paigefo/PP_KiCAD/teensy_library-master/README.md

Donate using Liberapay (https://liberapay.com/xengi/donate)

Teensy symbol library for KiCAD
=======================================

This repo includes KiCAD symbols for the following Teensy versions:

  - Teensy 1.0
  - Teensy++ 1.0
  - Teensy 2.0
  - Teensy++ 2.0
  - Teensy 3.0
  - Teensy 3.1
  - Teensy 3.2
  - Teensy 3.5
  - Teensy 3.6
  - Teensy 4.0
  - Teensy 4.1
  - Teensy LC

There are two symbols for Teensy 3.5/3.6: one that includes the through-hole connections on Teensy and one that adds all of the SMT connections on the bottom of the Teensy.

For footprints look here: https://github.com/XenGi/teensy.pretty
