paigefo/PP_KiCAD/2QC+2FSM/3220-10-0100-00.STEP

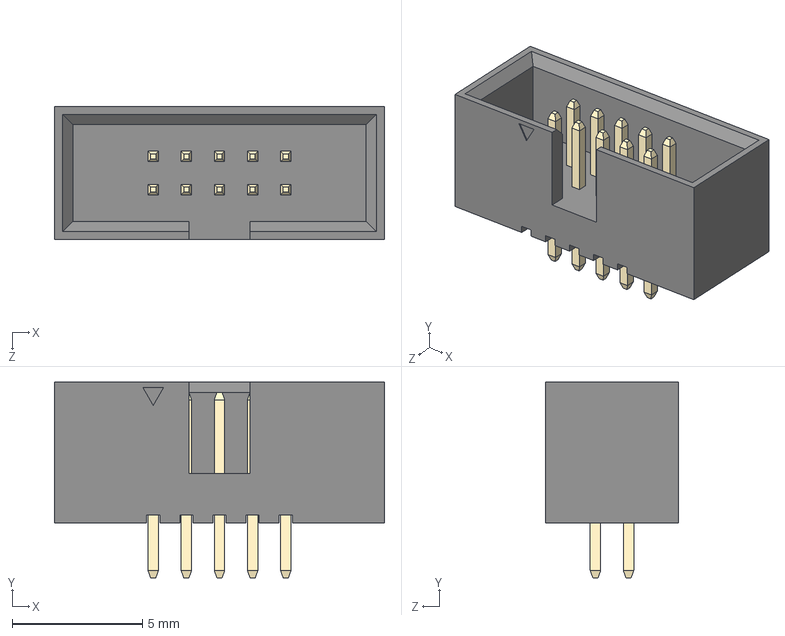
[picture p1: CAD file, 2025-09-08]
2QC+2FSM/3220-10-0100-00.STEP
12.7 x 7.50 x 5.10 mm
3220-xx-0100-00 body_10
Pin^3220-xx-0100-00 x 10
