paigefo/PP_KiCAD/Mirror+QC_Control.step

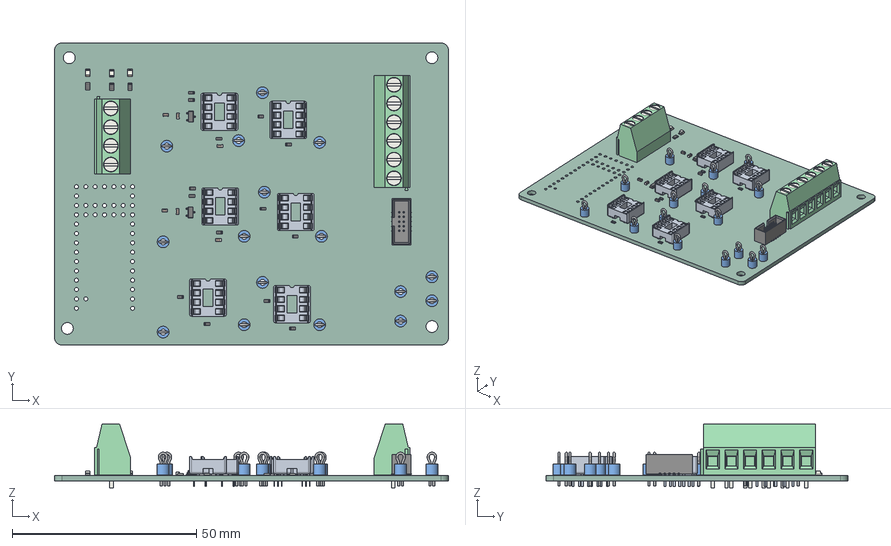
[picture p2: CAD file, 2025-09-08]
Mirror+QC_Control.step
107.0 x 82.0 x 17.3 mm
R_0603_1608Metric x 14
C_0603_1608Metric x 6
LED_0805_2012Metric x 3
TestPoint_Loop_D2.60mm_Drill1.6mm_Beaded x 16
c-1-2199298-2-a-3d x 6
SOT-23 x 2
R_0805_2012Metric x 3
TerminalBlock_Phoenix_MKDS-1,5-4-5.08_1x04_P5.08mm_Horizontal
3220-xx-0300-00 body_10
Pin^3220-xx-0300-00 x 5
MirrorPin^3220-xx-0300-00 x 5
TerminalBlock_Phoenix_MKDS-1,5-6-5.08_1x06_P5.08mm_Horizontal
Mirror+QC_Control_PCB
