paigefo/PP_KiCAD/2QC+2FSM/2QC+2FSM.kicad_pcb

## KiCad design 2QC+2FSM/2QC+2FSM.kicad_pcb (2025-10-07)

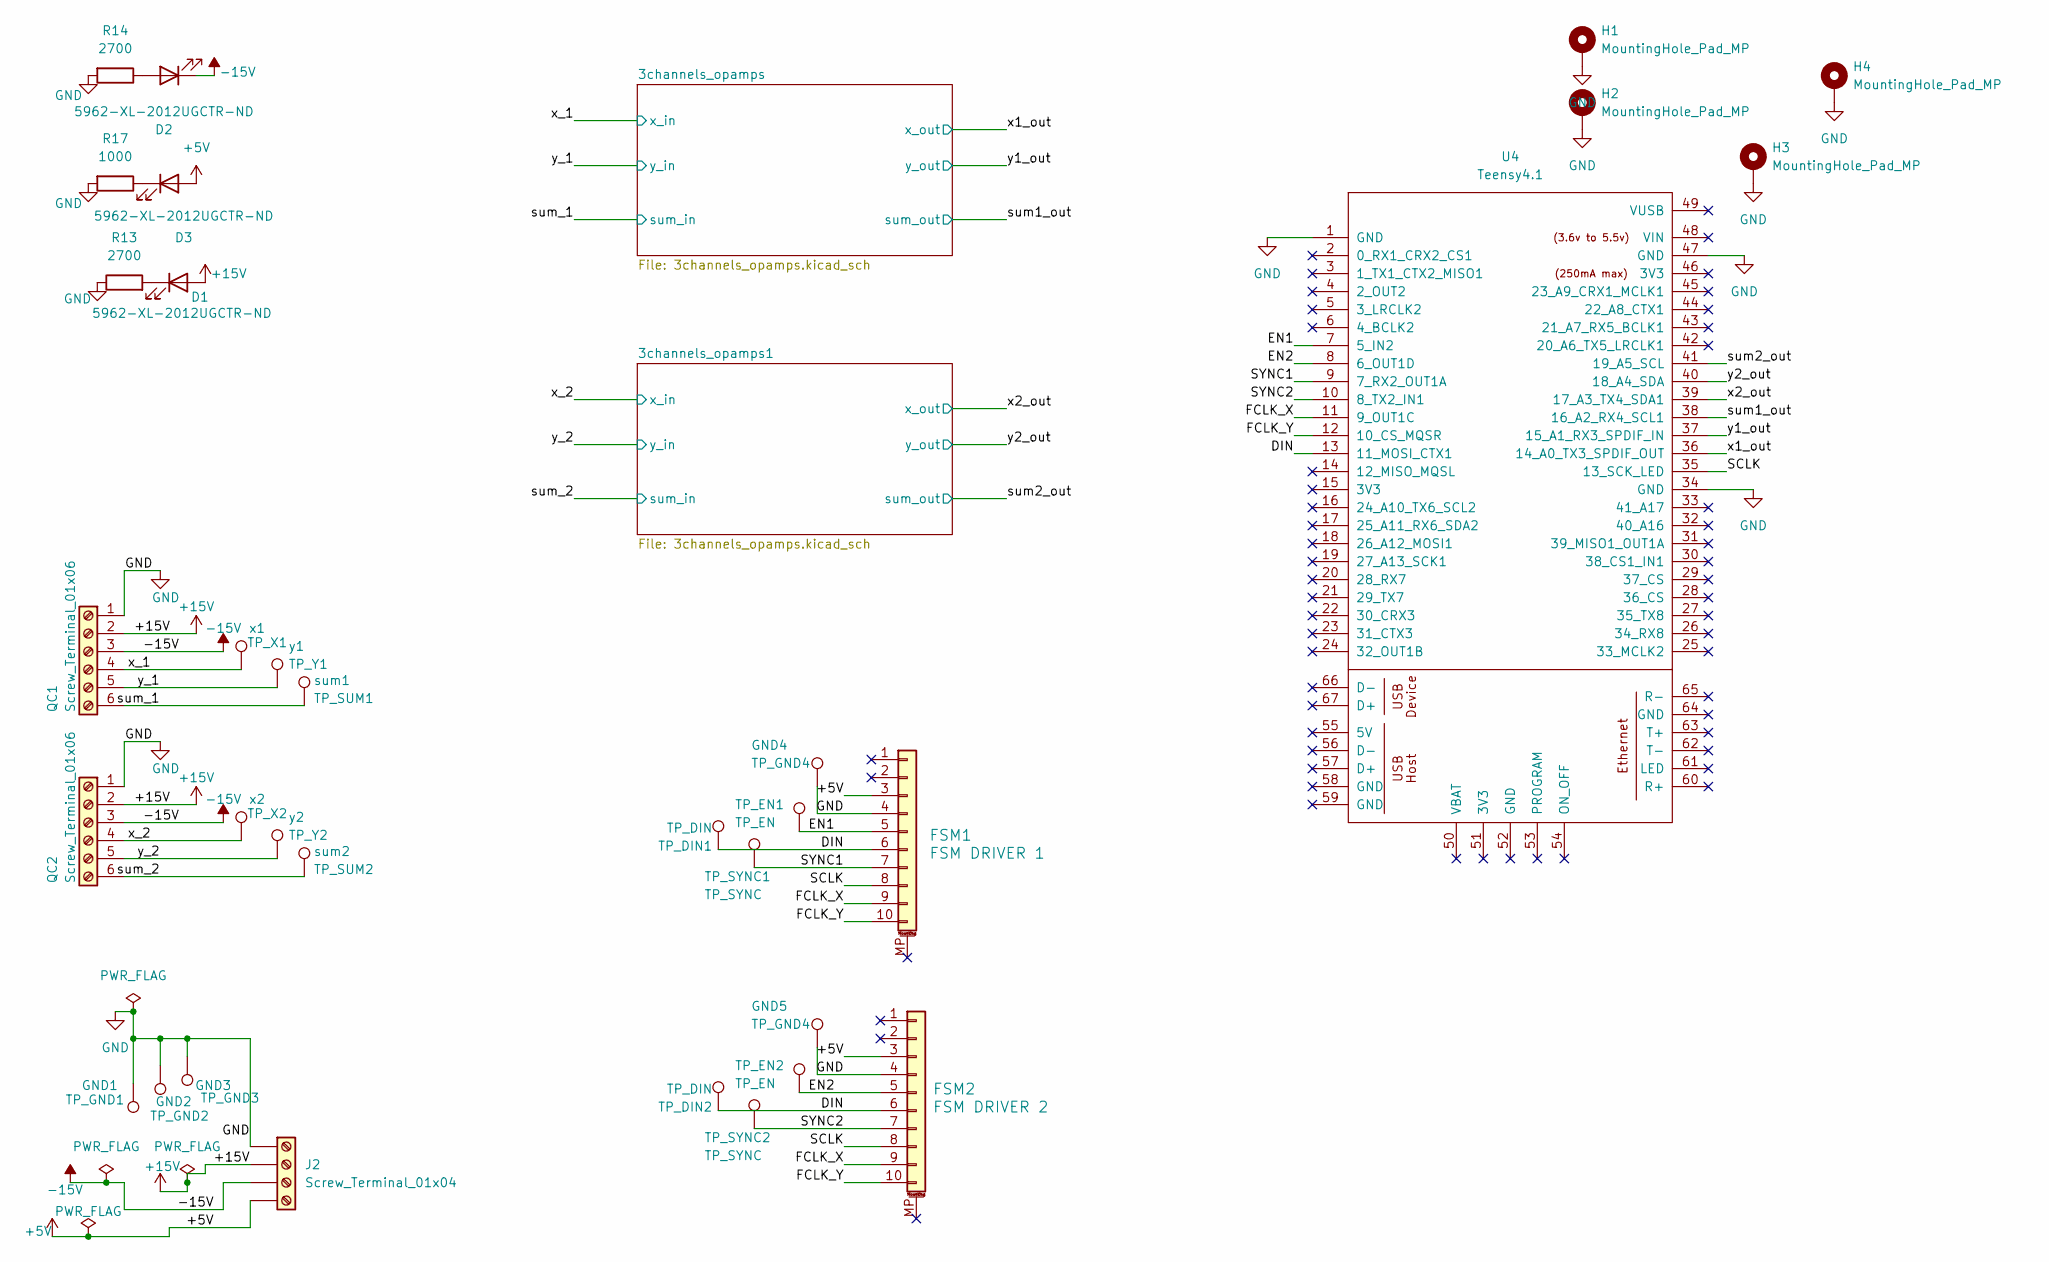
[picture p3: schematic 2QC+2FSM.kicad_sch, Teensy Control of 2QCs and 2FSMs]

Parts:
D1, D2, D3: 5962-XL-2012UGCTR-ND; LED_0805_2012Metric; LCSC C965815
FSM1: FSM DRIVER 1; CONN_3220-10-0100-00_CNC
FSM2: FSM DRIVER 2; CONN_3220-10-0100-00_CNC
GND1: TP_GND1; TestPoint_Loop_D2.60mm_Drill1.6mm_Beaded; LCSC C2906763
GND2: TP_GND2; TestPoint_Loop_D2.60mm_Drill1.6mm_Beaded; LCSC C2906763
GND3: TP_GND3; TestPoint_Loop_D2.60mm_Drill1.6mm_Beaded; LCSC C2906763
GND4, GND5: TP_GND4; TestPoint_Loop_D2.60mm_Drill1.6mm_Beaded; LCSC C2906763
H1, H2, H3, H4: MountingHole_Pad_MP; MountingHole_3.2mm_M3_DIN965_Pad_TopBottom
J2: Screw_Terminal_01x04; TerminalBlock_Phoenix_MKDS-1,5-4-5.08_1x04_P5.08mm_Horizont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; LCSC C5443561
QC1, QC2: Screw_Terminal_01x06; TerminalBlock_Phoenix_MKDS-1,5-6-5.08_1x06_P5.08mm_Horizont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; LCSC C2915642
R13, R14: 2700; R_0805_2012Metric; LCSC C2907305
R17: 1000; R_0805_2012Metric; LCSC C95781
TP_DIN1, TP_DIN2: TP_DIN; TestPoint_Loop_D2.60mm_Drill1.6mm_Beaded; LCSC C2906763
TP_EN1, TP_EN2: TP_EN; TestPoint_Loop_D2.60mm_Drill1.6mm_Beaded; LCSC C2906763
TP_SYNC1, TP_SYNC2: TP_SYNC; TestPoint_Loop_D2.60mm_Drill1.6mm_Beaded; LCSC C2906763
U4: Teensy4.1; Teensy41
sum1: TP_SUM1; TestPoint_Loop_D2.60mm_Drill1.6mm_Beaded; LCSC C2906763
sum2: TP_SUM2; TestPoint_Loop_D2.60mm_Drill1.6mm_Beaded; LCSC C2906763
x1: TP_X1; TestPoint_Loop_D2.60mm_Drill1.6mm_Beaded; LCSC C2906763
x2: TP_X2; TestPoint_Loop_D2.60mm_Drill1.6mm_Beaded; LCSC C2906763
y1: TP_Y1; TestPoint_Loop_D2.60mm_Drill1.6mm_Beaded; LCSC C2906763
y2: TP_Y2; TestPoint_Loop_D2.60mm_Drill1.6mm_Beaded; LCSC C2906763

Connections:
+5V: D3.2 (A), FSM1.3, FSM2.3, J2.4; also elsewhere on the board
+15V: D1.2 (A), J2.2, QC1.2, QC2.2; also elsewhere on the board
-15V: D2.1 (K), J2.3, QC1.3, QC2.3; also elsewhere on the board
/DIN: FSM1.6, FSM2.6, TP_DIN1.1, TP_DIN2.1, U4.13 (11_MOSI_CTX1)
/EN1: FSM1.5, TP_EN1.1, U4.7 (5_IN2)
/EN2: FSM2.5, TP_EN2.1, U4.8 (6_OUT1D)
/FCLK_X: FSM1.9, FSM2.9, U4.11 (9_OUT1C)
/FCLK_Y: FSM1.10, FSM2.10, U4.12 (10_CS_MQSR)
/SCLK: FSM1.8, FSM2.8, U4.35 (13_SCK_LED)
/SYNC1: FSM1.7, TP_SYNC1.1, U4.9 (7_RX2_OUT1A)
/SYNC2: FSM2.7, TP_SYNC2.1, U4.10 (8_TX2_IN1)
/sum1_out: U4.38 (16_A2_RX4_SCL1); also elsewhere on the board
/sum2_out: U4.41 (19_A5_SCL); also elsewhere on the board
/sum_1: QC1.6, sum1.1; also elsewhere on the board
/sum_2: QC2.6, sum2.1; also elsewhere on the board
/x1_out: U4.36 (14_A0_TX3_SPDIF_OUT); also elsewhere on the board
/x2_out: U4.39 (17_A3_TX4_SDA1); also elsewhere on the board
/x_1: QC1.4, x1.1; also elsewhere on the board
/x_2: QC2.4, x2.1; also elsewhere on the board
/y1_out: U4.37 (15_A1_RX3_SPDIF_IN); also elsewhere on the board
/y2_out: U4.40 (18_A4_SDA); also elsewhere on the board
/y_1: QC1.5, y1.1; also elsewhere on the board
/y_2: QC2.5, y2.1; also elsewhere on the board
GND: FSM1.4, FSM2.4, GND1.1, GND2.1, GND3.1, GND4.1, GND5.1, H1.MP, H2.MP, H3.MP, H4.MP, J2.1, QC1.1, QC2.1, R13.1, R14.2, R17.2, U4.1 (GND), U4.34 (GND), U4.47 (GND); also elsewhere on the board
unnamed: D1.1 (K), R13.2
unnamed: D2.2 (A), R14.1
unnamed: D3.1 (K), R17.1

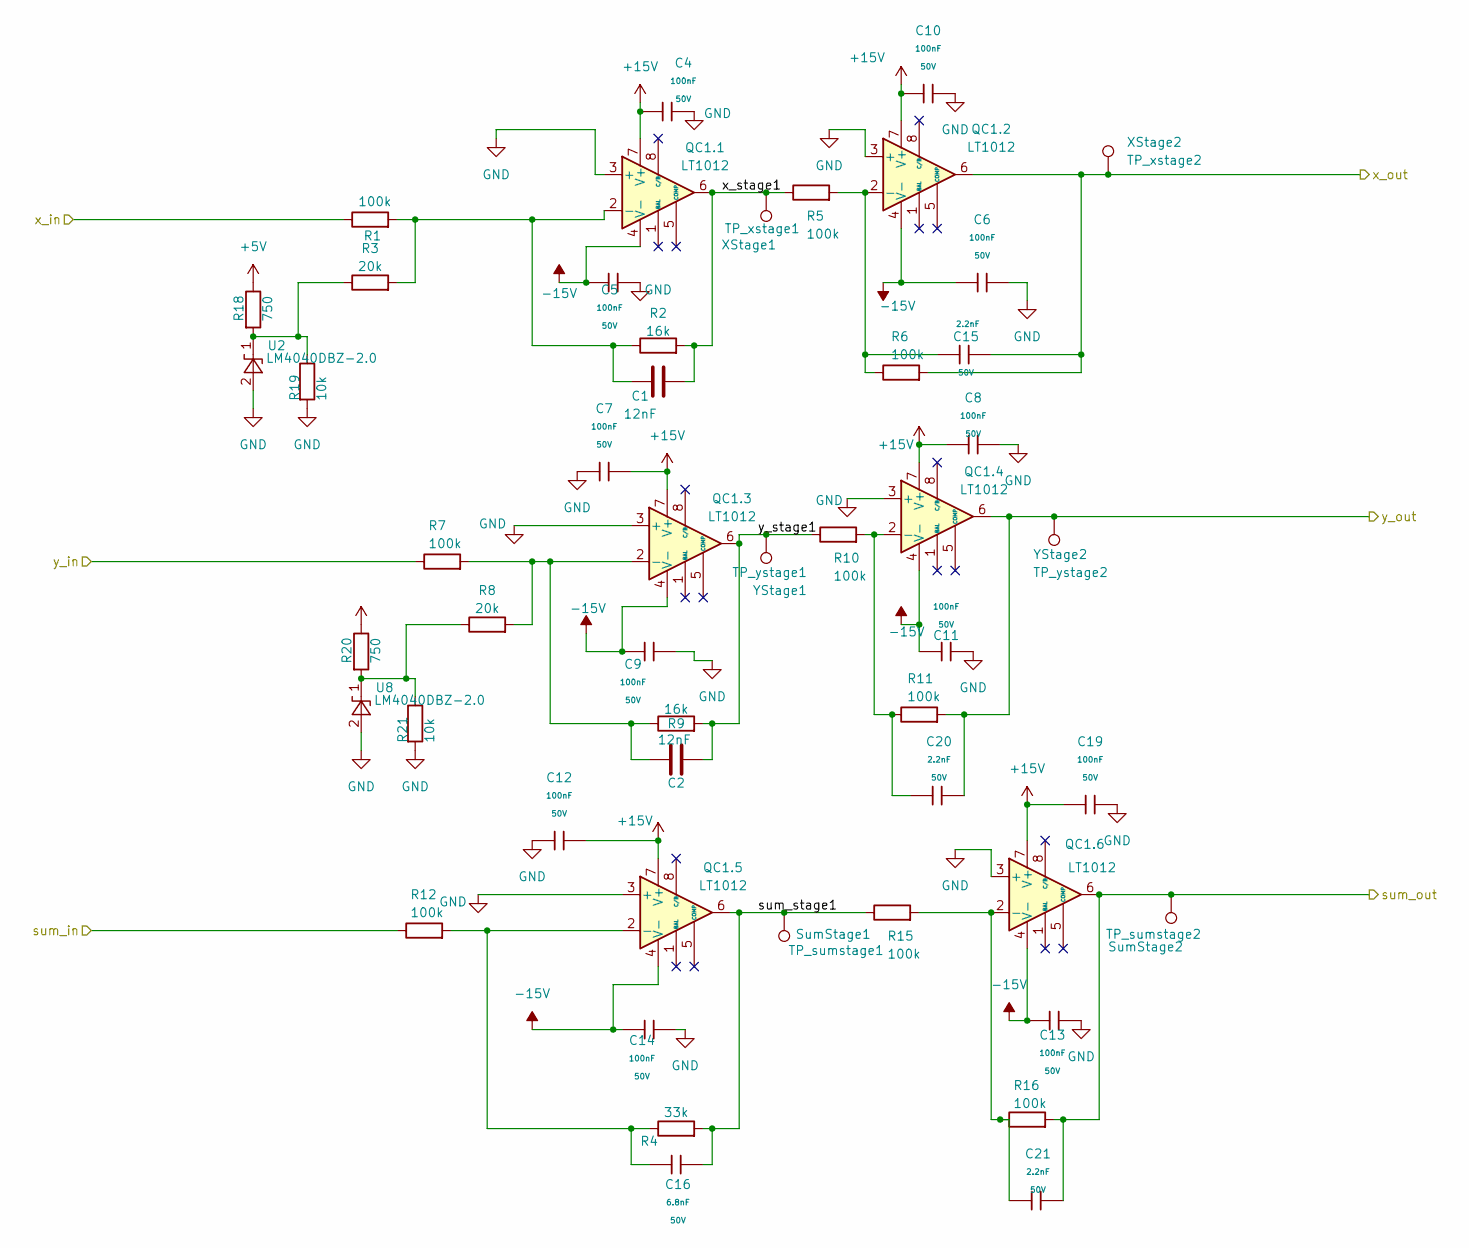
[picture p4: schematic 3channels_opamps.kicad_sch, X,Y,Sum conversion to 0-3.3V]

Parts:
C1, C2: 12nF; C_0603_1608Metric; LCSC C107074
C4, C5, C6, C7, C8, C9, C10, C11, C12, C13, C14, C19: 100nF; C_0603; Voltage Rated 50V; Tolerance ±10%; Part CC0603KRX7R9BB104; LCSC C14663
C15, C20, C21: 2.2nF; C_0603; Voltage Rated 50V; Tolerance ±10%; Part 0603B222K500NT; LCSC C1604
C16: 6.8nF; C_0603; Voltage Rated 50V; Tolerance ±10%; Part 0603B682K500NT; LCSC C1631
QC1.1, QC1.2, QC1.3, QC1.4, QC1.5, QC1.6: LT1012; CONN8_1-2199298-2_TEC; LCSC C305904
R1, R5, R6, R7, R10, R11, R12, R15, R16: 100k; R_0603_1608Metric; LCSC C14675
R2, R9: 16k; R_0603_1608Metric; LCSC C2907107
R3, R8: 20k; R_0603_1608Metric; LCSC C2907011
R4: 33k; R_0603_1608Metric; LCSC C2907028
R18, R20: 750; C_0603_1608Metric; LCSC C2907066
R19, R21: 10k; C_0603_1608Metric; LCSC C2930027
SumStage1: TP_sumstage1; TestPoint_Loop_D2.60mm_Drill1.6mm_Beaded; LCSC C2906763
SumStage2: TP_sumstage2; TestPoint_Loop_D2.60mm_Drill1.6mm_Beaded; LCSC C2906763
U2, U8: LM4040DBZ-2.0; SOT-23; LCSC C431732
XStage1: TP_xstage1; TestPoint_Loop_D2.60mm_Drill1.6mm_Beaded; LCSC C2906763
XStage2: TP_xstage2; TestPoint_Loop_D2.60mm_Drill1.6mm_Beaded; LCSC C2906763
YStage1: TP_ystage1; TestPoint_Loop_D2.60mm_Drill1.6mm_Beaded; LCSC C2906763
YStage2: TP_ystage2; TestPoint_Loop_D2.60mm_Drill1.6mm_Beaded; LCSC C2906763

Connections:
+5V: R18.1, R20.1; also elsewhere on the board
+15V: C4.1, C7.2, C8.1, C10.1, C12.2, C19.1, QC1.1.7 (V+), QC1.2.7 (V+), QC1.3.7 (V+), QC1.4.7 (V+), QC1.5.7 (V+), QC1.6.7 (V+); also elsewhere on the board
-15V: C5.1, C6.1, C9.1, C11.1, C13.1, C14.1, QC1.1.4 (V-), QC1.2.4 (V-), QC1.3.4 (V-), QC1.4.4 (V-), QC1.5.4 (V-), QC1.6.4 (V-); also elsewhere on the board
/3channels_opamps/sum_stage1: C16.2, QC1.5.6, R4.2, R15.1, SumStage1.1
/3channels_opamps/x_stage1: C1.2, QC1.1.6, R2.2, R5.1, XStage1.1
/3channels_opamps/y_stage1: C2.1, QC1.3.6, R9.2, R10.1, YStage1.1
/sum1_out: C21.2, QC1.6.6, R16.2, SumStage2.1; also elsewhere on the board
/sum_1: R12.1; also elsewhere on the board
/x1_out: C15.2, QC1.2.6, R6.2, XStage2.1; also elsewhere on the board
/x_1: R1.1; also elsewhere on the board
/y1_out: C20.2, QC1.4.6, R11.2, YStage2.1; also elsewhere on the board
/y_1: R7.1; also elsewhere on the board
GND: C4.2, C5.2, C6.2, C7.1, C8.2, C9.2, C10.2, C11.2, C12.1, C13.2, C14.2, C19.2, QC1.1.3 (+), QC1.2.3 (+), QC1.3.3 (+), QC1.4.3 (+), QC1.5.3 (+), QC1.6.3 (+), R19.2, R21.2, U2.2 (A), U8.2 (A); also elsewhere on the board
unnamed: C1.1, QC1.1.2 (-), R1.2, R2.1, R3.2
unnamed: C15.1, QC1.2.2 (-), R5.2, R6.1
unnamed: C2.2, QC1.3.2 (-), R7.2, R8.2, R9.1
unnamed: C20.1, QC1.4.2 (-), R10.2, R11.1
unnamed: C16.1, QC1.5.2 (-), R4.1, R12.2
unnamed: C21.1, QC1.6.2 (-), R15.2, R16.1
unnamed: R3.1, R18.2, R19.1, U2.1 (K)
unnamed: R8.1, R20.2, R21.1, U8.1 (K)

Parts of its further copies:
C3, C17, C18, C22, C23, C25, C28, C30, C32, C33, C35, C36: 100nF; C_0603; Voltage Rated 50V; Tolerance ±10%; Part CC0603KRX7R9BB104; LCSC C14663
C24, C26: 12nF; C_0603_1608Metric; LCSC C107074
C27: 6.8nF; C_0603; Voltage Rated 50V; Tolerance ±10%; Part 0603B682K500NT; LCSC C1631
C29, C31, C34: 2.2nF; C_0603; Voltage Rated 50V; Tolerance ±10%; Part 0603B222K500NT; LCSC C1604
QC2.1, QC2.2, QC2.3, QC2.4, QC2.5, QC2.6: LT1012; CONN8_1-2199298-2_TEC; LCSC C305904
R22, R24: 750; C_0603_1608Metric; LCSC C2907066
R23, R27: 10k; C_0603_1608Metric; LCSC C2930027
R25, R28, R29, R34, R35, R36, R37, R38, R39: 100k; R_0603_1608Metric; LCSC C14675
R26, R30: 20k; R_0603_1608Metric; LCSC C2907011
R31, R32: 16k; R_0603_1608Metric; LCSC C2907107
R33: 33k; R_0603_1608Metric; LCSC C2907028
SumStage3: TP_sumstage1; TestPoint_Loop_D2.60mm_Drill1.6mm_Beaded; LCSC C2906763
SumStage4: TP_sumstage2; TestPoint_Loop_D2.60mm_Drill1.6mm_Beaded; LCSC C2906763
U7, U9: LM4040DBZ-2.0; SOT-23; LCSC C431732
XStage3: TP_xstage1; TestPoint_Loop_D2.60mm_Drill1.6mm_Beaded; LCSC C2906763
XStage4: TP_xstage2; TestPoint_Loop_D2.60mm_Drill1.6mm_Beaded; LCSC C2906763
YStage3: TP_ystage1; TestPoint_Loop_D2.60mm_Drill1.6mm_Beaded; LCSC C2906763
YStage4: TP_ystage2; TestPoint_Loop_D2.60mm_Drill1.6mm_Beaded; LCSC C2906763

Connections of its further copies:
+5V: R22.1, R24.1; also elsewhere on the board
+15V: C3.2, C17.2, C25.1, C28.1, C32.1, C36.1, QC2.1.7 (V+), QC2.2.7 (V+), QC2.3.7 (V+), QC2.4.7 (V+), QC2.5.7 (V+), QC2.6.7 (V+); also elsewhere on the board
-15V: C18.1, C22.1, C23.1, C30.1, C33.1, C35.1, QC2.1.4 (V-), QC2.2.4 (V-), QC2.3.4 (V-), QC2.4.4 (V-), QC2.5.4 (V-), QC2.6.4 (V-); also elsewhere on the board
/3channels_opamps1/sum_stage1: C27.2, QC2.5.6, R33.2, R36.1, SumStage3.1
/3channels_opamps1/x_stage1: C24.2, QC2.1.6, R31.2, R34.1, XStage3.1
/3channels_opamps1/y_stage1: C26.1, QC2.3.6, R32.2, R35.1, YStage3.1
/sum2_out: C34.2, QC2.6.6, R39.2, SumStage4.1; also elsewhere on the board
/sum_2: R28.1; also elsewhere on the board
/x2_out: C31.2, QC2.2.6, R37.2, XStage4.1; also elsewhere on the board
/x_2: R25.1; also elsewhere on the board
/y2_out: C29.2, QC2.4.6, R38.2, YStage4.1; also elsewhere on the board
/y_2: R29.1; also elsewhere on the board
GND: C3.1, C17.1, C18.2, C22.2, C23.2, C25.2, C28.2, C30.2, C32.2, C33.2, C35.2, C36.2, QC2.1.3 (+), QC2.2.3 (+), QC2.3.3 (+), QC2.4.3 (+), QC2.5.3 (+), QC2.6.3 (+), R23.2, R27.2, U7.2 (A), U9.2 (A); also elsewhere on the board
unnamed: C24.1, QC2.1.2 (-), R25.2, R26.2, R31.1
unnamed: C31.1, QC2.2.2 (-), R34.2, R37.1
unnamed: C26.2, QC2.3.2 (-), R29.2, R30.2, R32.1
unnamed: C29.1, QC2.4.2 (-), R35.2, R38.1
unnamed: C27.1, QC2.5.2 (-), R28.2, R33.1
unnamed: C34.1, QC2.6.2 (-), R36.2, R39.1
unnamed: R22.2, R23.1, R26.1, U7.1 (K)
unnamed: R24.2, R27.1, R30.1, U9.1 (K)

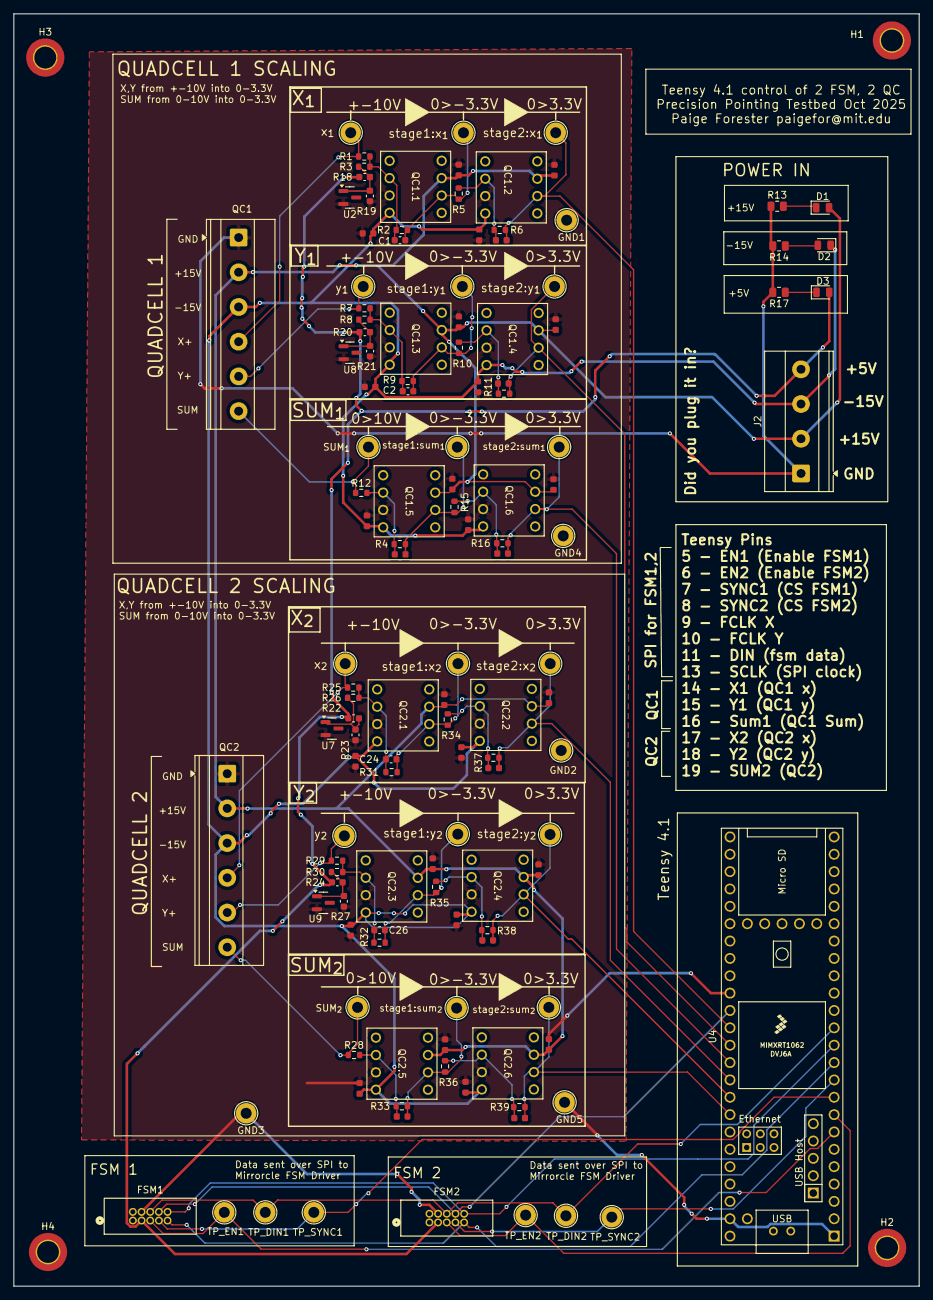
[picture p5: board 2QC+2FSM.kicad_pcb from above]

Board: 2 copper layers, 132.5 x 186.2 mm, 133 parts (0 on the bottom side), 49 nets.

Other parts of the board:
x_{1}: TP_X1; TestPoint_Loop_D2.60mm_Drill1.6mm_Beaded

Their connections:
/x_1: x_{1}.1; also elsewhere on the board
