paigefo/PP_KiCAD/Mirror+QC_Control.kicad_pcb

## KiCad design Mirror+QC_Control.kicad_pcb (2025-09-08)

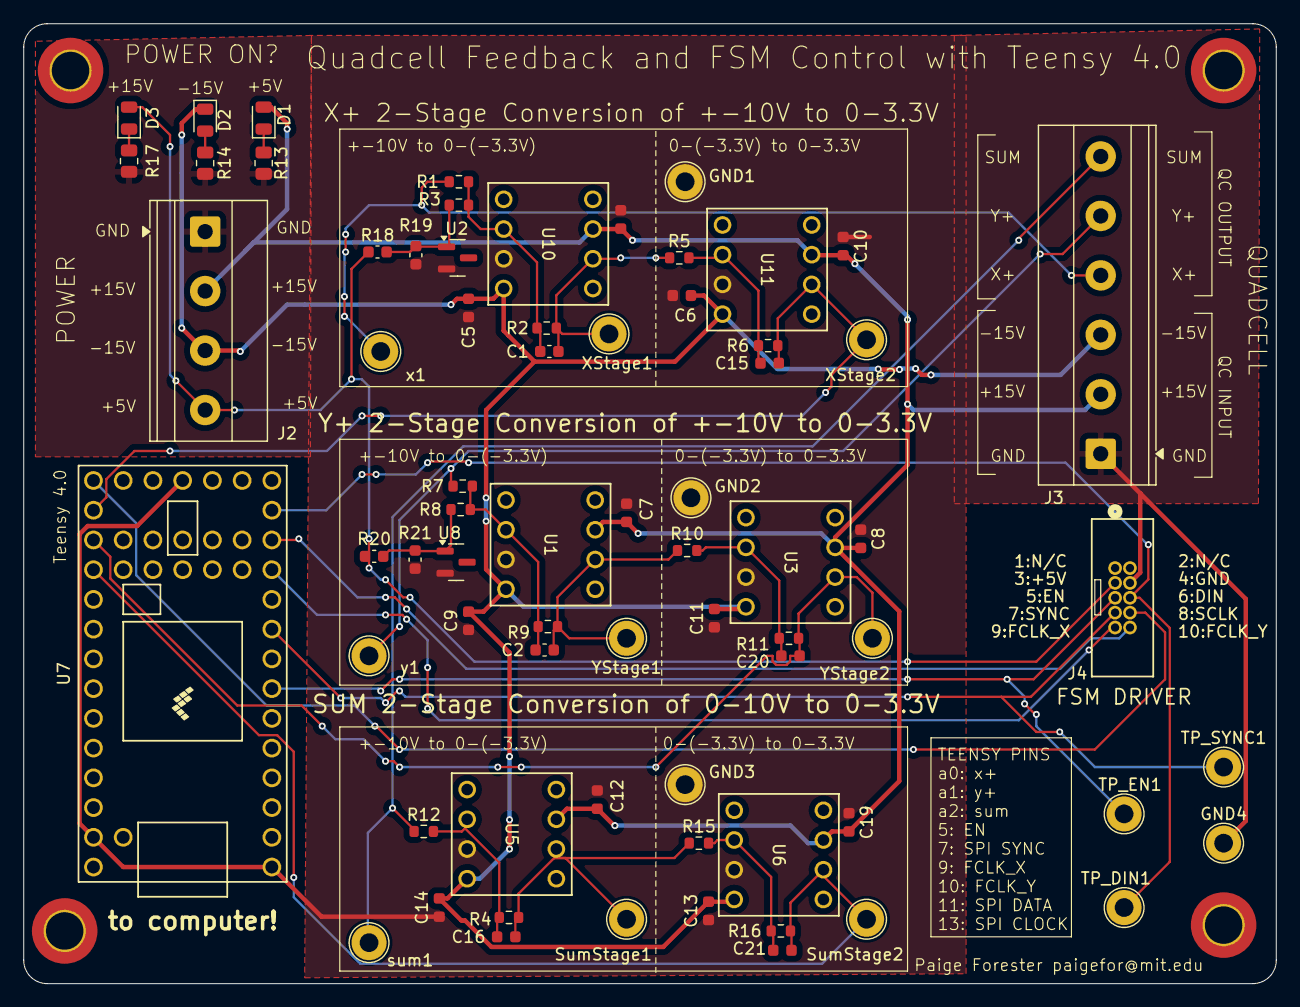
[picture p6: board Mirror+QC_Control.kicad_pcb from above]

Board: 2 copper layers, 107.0 x 82.0 mm, 74 parts (0 on the bottom side), 30 nets.

Parts:
C1, C2: 12nF; C_0603_1608Metric
C4, C5, C6, C7, C8, C9, C10, C11, C12, C13, C14, C19: 100nF; C_0603
C15, C20, C21: 2.2nF; C_0603
C16: 6.8nF; C_0603
D1, D2, D3: 5962-XL-2012UGCTR-ND; LED_0805_2012Metric
GND1: TP_GND1; TestPoint_Loop_D2.60mm_Drill1.6mm_Beaded
GND2: TP_GND2; TestPoint_Loop_D2.60mm_Drill1.6mm_Beaded
GND3: TP_GND3; TestPoint_Loop_D2.60mm_Drill1.6mm_Beaded
GND4: TP_GND4; TestPoint_Loop_D2.60mm_Drill1.6mm_Beaded
H1, H2, H3, H4: MountingHole_Pad_MP; MountingHole_3.2mm_M3_DIN965_Pad_TopBottom
J2: Screw_Terminal_01x04; TerminalBlock_Phoenix_MKDS-1,5-4-5.08_1x04_P5.08mm_Horizont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
J3: Screw_Terminal_01x06; TerminalBlock_Phoenix_MKDS-1,5-6-5.08_1x06_P5.08mm_Horizont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
J4: FSM DRIVER; CONN_3220-10-0100-00_CNC
R1, R5, R6, R7, R10, R11, R12, R15, R16: 100k; R_0603_1608Metric
R2, R9: 16k; R_0603_1608Metric
R3, R8: 20k; R_0603_1608Metric
R4: 33k; R_0603_1608Metric
R13, R14: 1200; R_0805_2012Metric
R17: 300; R_0805_2012Metric
R18, R20: 750; C_0603_1608Metric
R19, R21: 10k; C_0603_1608Metric
SumStage1: TP_sumstage1; TestPoint_Loop_D2.60mm_Drill1.6mm_Beaded
SumStage2: TP_sumstage2; TestPoint_Loop_D2.60mm_Drill1.6mm_Beaded
TP_DIN1: TP_DIN; TestPoint_Loop_D2.60mm_Drill1.6mm_Beaded
TP_EN1: TP_EN; TestPoint_Loop_D2.60mm_Drill1.6mm_Beaded
TP_SYNC1: TP_SYNC; TestPoint_Loop_D2.60mm_Drill1.6mm_Beaded
U1, U3, U5, U6, U10, U11: LT1012; CONN8_1-2199298-2_TEC
U2, U8: LM4040DBZ-2.0; SOT-23
U7: Teensy4.0; Teensy40
XStage1: TP_xstage1; TestPoint_Loop_D2.60mm_Drill1.6mm_Beaded
XStage2: TP_xstage2; TestPoint_Loop_D2.60mm_Drill1.6mm_Beaded
YStage1: TP_ystage1; TestPoint_Loop_D2.60mm_Drill1.6mm_Beaded
YStage2: TP_ystage2; TestPoint_Loop_D2.60mm_Drill1.6mm_Beaded
sum1: TP_SUM; TestPoint_Loop_D2.60mm_Drill1.6mm_Beaded
x1: TP_X; TestPoint_Loop_D2.60mm_Drill1.6mm_Beaded
y1: TP_Y; TestPoint_Loop_D2.60mm_Drill1.6mm_Beaded

Connections:
+5V: D3.2 (A), J2.4, J4.3, R18.1, R20.1
+15V: C4.1, C7.2, C8.1, C10.1, C12.2, C19.1, D1.2 (A), J2.2, J3.2, U1.7 (V+), U3.7 (V+), U5.7 (V+), U6.7 (V+), U10.7 (V+), U11.7 (V+)
-15V: C5.1, C6.1, C9.1, C11.1, C13.1, C14.1, D2.1 (K), J2.3, J3.3, U1.4 (V-), U3.4 (V-), U5.4 (V-), U6.4 (V-), U10.4 (V-), U11.4 (V-)
/DIN: J4.6, TP_DIN1.1, U7.13 (11_MOSI_CTX1)
/EN: J4.5, TP_EN1.1, U7.7 (5_IN2)
/FCLK_X: J4.9, U7.11 (9_OUT1C)
/FCLK_Y: J4.10, U7.12 (10_CS_MQSR)
/SCLK: J4.8, U7.20 (13_SCK_CRX1_LED)
/SYNC: J4.7, TP_SYNC1.1, U7.9 (7_RX2_OUT1A)
/sum: J3.6, R12.1, sum1.1
/sum_stage1: C16.2, R4.2, R15.1, SumStage1.1, U5.6
/sum_stage2: C21.2, R16.2, SumStage2.1, U6.6, U7.23 (16_A2_RX4_SCL1)
/x+: J3.4, R1.1, x1.1
/x_stage1: C1.2, R2.2, R5.1, U10.6, XStage1.1
/x_stage2: C15.2, R6.2, U7.21 (14_A0_TX3_SPDIF_OUT), U11.6, XStage2.1
/y+: J3.5, R7.1, y1.1
/y_stage1: C2.1, R9.2, R10.1, U1.6, YStage1.1
/y_stage2: C20.2, R11.2, U3.6, U7.22 (15_A1_RX3_SPDIF_IN), YStage2.1
GND: C4.2, C5.2, C6.2, C7.1, C8.2, C9.2, C10.2, C11.2, C12.1, C13.2, C14.2, C19.2, GND1.1, GND2.1, GND3.1, GND4.1, J2.1, J3.1, J4.4, R13.1, R14.2, R17.2, R19.2, R21.2, U1.3 (+), U2.2 (A), U3.3 (+), U5.3 (+), U6.3 (+), U7.1 (GND), U7.17 (GND), U7.32 (GND), U8.2 (A), U10.3 (+), U11.3 (+)
unnamed: D1.1 (K), R13.2
unnamed: D2.2 (A), R14.1
unnamed: D3.1 (K), R17.1
unnamed: C2.2, R7.2, R8.2, R9.1, U1.2 (-)
unnamed: R3.1, R18.2, R19.1, U2.1 (K)
unnamed: C20.1, R10.2, R11.1, U3.2 (-)
unnamed: C16.1, R4.1, R12.2, U5.2 (-)
unnamed: C21.1, R15.2, R16.1, U6.2 (-)
unnamed: R8.1, R20.2, R21.1, U8.1 (K)
unnamed: C1.1, R1.2, R2.1, R3.2, U10.2 (-)
unnamed: C15.1, R5.2, R6.1, U11.2 (-)
