paigefo/PP_KiCAD/(commit log)

2025-07-16 changes after DR1
    [Mirror+QC_Control.kicad_pcb, Mirror+QC_Control.kicad_sch]
2025-07-16 changes since DR2
    [Mirror+QC_Control.kicad_pcb, Mirror+QC_Control.kicad_sch]
2025-07-16 added LCSC values and refined silkscreen. still missing capacitor values for LPFs
    [Mirror+QC_Control.kicad_pcb, Mirror+QC_Control.kicad_sch]
2025-07-17 changes include capacitance values for LPFs
    [Mirror+QC_Control.kicad_pcb, Mirror+QC_Control.kicad_sch]
2025-07-17 final changes to board with nice layout
    [Mirror+QC_Control.kicad_pcb, Mirror+QC_Control.kicad_sch, bom.csv, designators.csv, positions.csv]
2025-07-17 adding all LCSC part numbers
    [Mirror+QC_Control-B_Cu.gbr, Mirror+QC_Control-B_Mask.gbr, Mirror+QC_Control-B_Paste.gbr, Mirror+QC_Control-B_Silkscreen.gbr, Mirror+QC_Control-Edge_Cuts.gbr, Mirror+QC_Control-F_Cu.gbr, Mirror+QC_Control-F_Mask.gbr, Mirror+QC_Control-F_Paste.gbr]
2025-07-17 added OpAmp drop in parts and oriented properly
    [Mirror+QC_Control-B_Cu.gbr, Mirror+QC_Control-B_Mask.gbr, Mirror+QC_Control-B_Paste.gbr, Mirror+QC_Control-B_Silkscreen.gbr, Mirror+QC_Control-Edge_Cuts.gbr, Mirror+QC_Control-F_Cu.gbr, Mirror+QC_Control-F_Mask.gbr, Mirror+QC_Control-F_Paste.gbr]
2025-07-17 adding dropped silkscreen text
    [Mirror+QC_Control.kicad_pcb]
2025-07-21 removing fake FSM connector, must solder digikey components
    [Mirror+QC_Control.kicad_pcb, Mirror+QC_Control.kicad_sch, bom.csv]
2025-07-22 rearranged board for enclosure compatability
    [Mirror+QC_Control.kicad_pcb, Mirror+QC_Control.kicad_sch, Mirror+QC_Control.step, bom.csv, designators.csv, positions.csv]
2025-09-08 second file for 2QC and 2FSM
    [2QC+2FSM.kicad_pcb, 2QC+2FSM.kicad_sch, 3220-10-0100-00.STEP, 3channels_opamps.kicad_sch, Mirror+QC_Control.kicad_pcb, Mirror+QC_Control.kicad_sch, Mirror+QC_Control.step, opamp1.kicad_sch]
2025-10-06 board layout
    [2QC+2FSM.kicad_pcb, 2QC+2FSM.kicad_sch, 3channels_opamps.kicad_sch]
2025-10-07 added text and modified layout
    [2QC+2FSM.kicad_pcb]
